Rowzun/Imagine-School-Nepal-Site-NIC-Field-Mapper-Bot/README.md

# Field Mapper Robot

## Overview
Design of a **modular, cost‑effective robot** for mapping magnetic fields within a defined volume.
<div align="center">
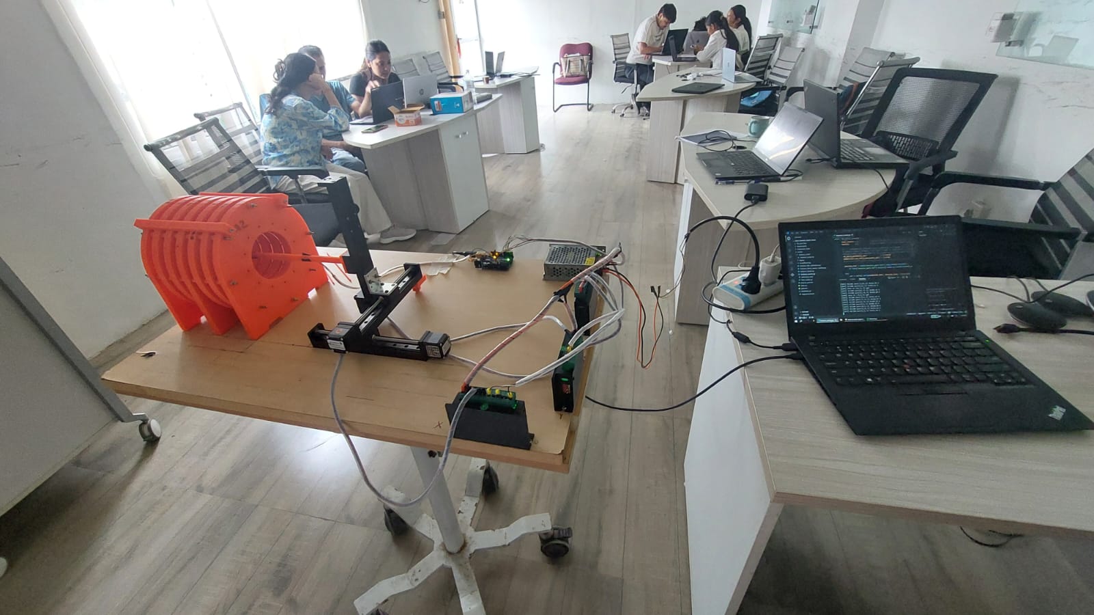
[picture p1: Attachments/image1.jpeg]
  
</div>

## Software requirements
* **PyCharm** – Python IDE (Python 3.13) – [Link](https://www.jetbrains.com/pycharm/)
* **Arduino IDE** – Native Arduino software – [Link](https://www.arduino.cc/en/software/)
* **VS Code** – Native Arduino software – [Link](https://www.arduino.cc/en/software/)

## Hardware requirements
* **CPU:** 64‑bit dual‑core (modern)  
* **RAM:** ≥ 8 GB (PyCharm needs 2 GB free)  
* **Storage:** ≥ 5 GB free SSD (PyCharm ≈ 3.5 GB + projects)  
* **OS:** Windows 10 64‑bit +, macOS 10.15 +, Ubuntu 20.04 +  
* Basic jumper wires for Arduino  
* M3 screws with nuts  
* USB‑C ↔ USB‑C / USB‑A ↔ USB‑C cable (Arduino Uno R4)  
* Wire cutter/stripper  
* Precision screwdriver set  

---

## Bill of Materials
| Component | Qty | Unit Price (USD) | Link |
|---|:---:|:---:|---|
| Linear stages (Z 300 mm, XY 300 mm – 12 mm pitch) | 1 | 338.54 | [Product](https://www.aliexpress.us/item/3256805348651313.html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) |
| M422 stepper driver | 3 | 5.60 | [Product](https://www.aliexpress.us/item/3256805781393725.html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) |
| Arduino UNO | 1 | 16.00 | [Product](https://thepihut.com/products/arduino-uno-r4-minima) |
| SS49e Hall sensor | 1 | 1 | [Product](https://www.alphalabinc.com/products/gm2/?srsltid=AfmBOor0p2l-VF9fIRODsZqY854WaDDNnBIFsOJ6kHjN2p6iCgCOzTLX) |
| **Total** |  | **361.14** |  |

---

## High‑Level Workflow

<div align="center">
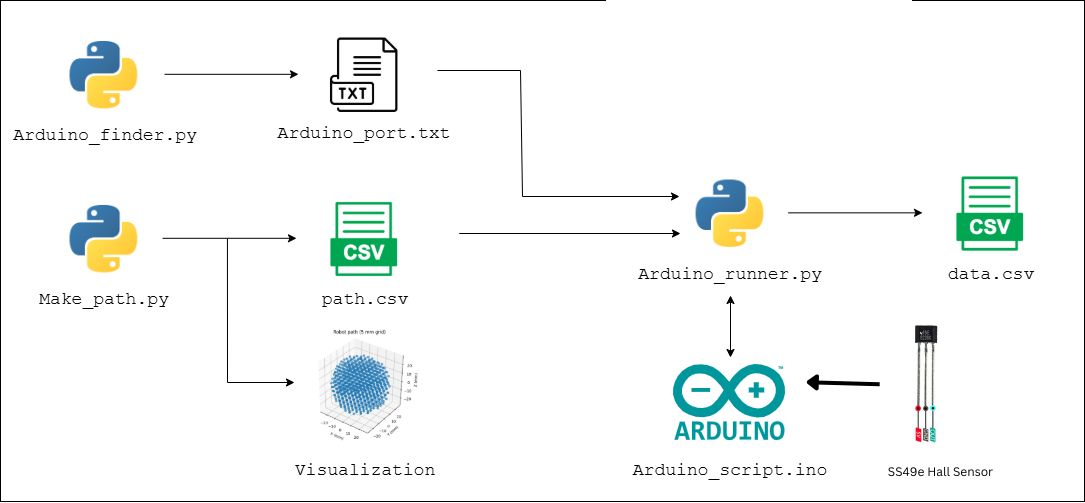
[picture p2: Attachments/draw_1.png]
System flowchart 1
  
</div>
<h3 align="center"><em>Software workflow diagram</em></h3>

<div align="center">
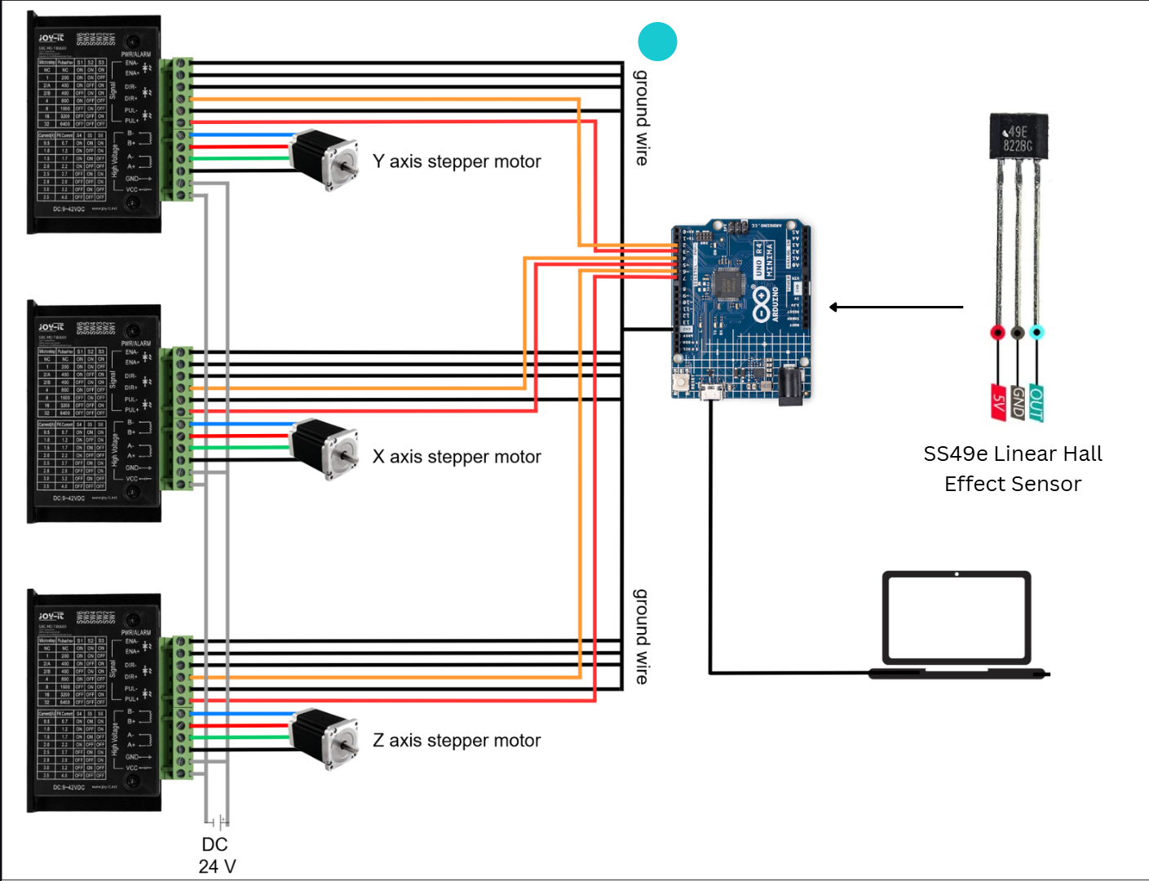
[picture p3: Attachments/draw_2.png]
System flowchart 2
  
</div>
<h3 align="center"><em>Wiring diagram</em></h3>

## Installation and Setup  

1. Clone the repository:  
    ```bash  
    git clone https://github.com/Rowzun/Imagine-School-Nepal-Site-NIC-Field-Mapper-Bot.git
    ```  
2. Install dependencies:  
    ```bash  
    pip install -r requirements.txt  
    ```  
3. Connect the hardware as described in the wiring diagram.
4. Print the files in [3D print files](3D_print_files)
5. Connect and upload [`Arduino_script.ino`](scripts/Arduino_script.ino) to Arduino
6. Run [`Arduino_finder.py`](scripts/Arduino_finder.py)
7. Run [`Path_maker.py`](scripts/Path_maker.py)
8. Run [`Arduino_runner.py`](scripts/Arduino_runner.py)
9. Check out [`Supporting images`](Attachments/Supporting%20images/) for further images
---

## Scripts Overview  

### [`Arduino_finder.py`](scripts/Arduino_finder.py)

- Run once the arduino is connected 
- Finds the connection port name and writes it in Arduino_port.txt file 

### [`Path_maker.py`](scripts/Path_maker.py)

- Generates the path trajectory with discrete points
- Allows user to modify the trajectory and spacing between individual points
- Visualizes the path in 3D with exact sequence the robot would follow, for user to validate
- Writes the x y z coordinates of the path in the right order in "path.CSV" file

### [`Arduino_runner.py`](scripts/Arduino_runner.py)
  
- Allows user to input delay time for sensor read at each desired point and control the speed of robot movement
- Retrieves the coordinates from "path.CSV" file
- Generates text commands to move the robot according to the path
- Sends text commands to arduino at 9600 baud (defined by user) via Arduino port retrieved from Arduino.txt file
- Establishes a serial connection with Gaussmeter through usb port
- Records voltage readings of Gaussmeter per data point and appends to corresponding coordinate
- Generates Data.CSV, containing x y z reading values for each coordinates

### [`Arduino_script.ino`](scripts/Arduino_script.ino)
- Defines Pin map of the arduino
- Listens for simple text commands (X+, X-, Y+, Y-, Z+, Z-,) sent over USB at 9600 baud (Links [`Arduino_runner.py`](scripts/Arduino_runner.py) with Arduino)
- Moves the robot 1 mm per command by pulsing the chosen step pin 533.34 times (defined by callibration)
- Read the raw ADC values from the SS49e hall sensor and using the calibration values, convert the voltage value to gauss and print to serial when prompted

---
## Assembly Tips

### 1 · Axis Ruler for Quick Calibration
<div align="center">
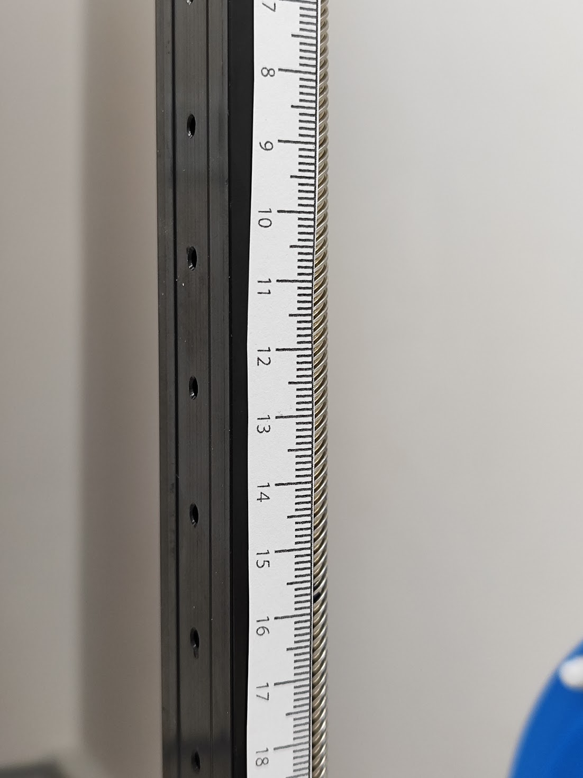
[picture p4: Attachments/tip1.jpg]
  
</div>
Attaching a printed ruler minimises calibration time and ensures precise step‑to‑millimetre mapping.

### 2 · Mount on a Rigid Base
<div align="center">
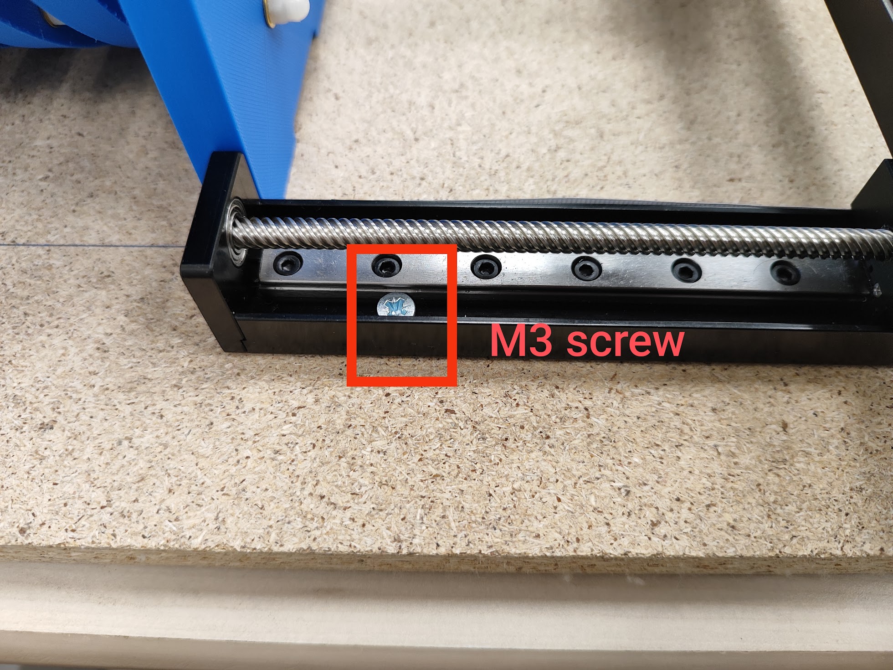
[picture p5: Attachments/tip2.jpg]
Robot mounted on wooden panel
  
</div>
Secure the frame to a **≥ 40 × 60 × 1.5 cm** wooden panel for stability during operation.

### 3 · Variable DC Power Supply
<div align="center">
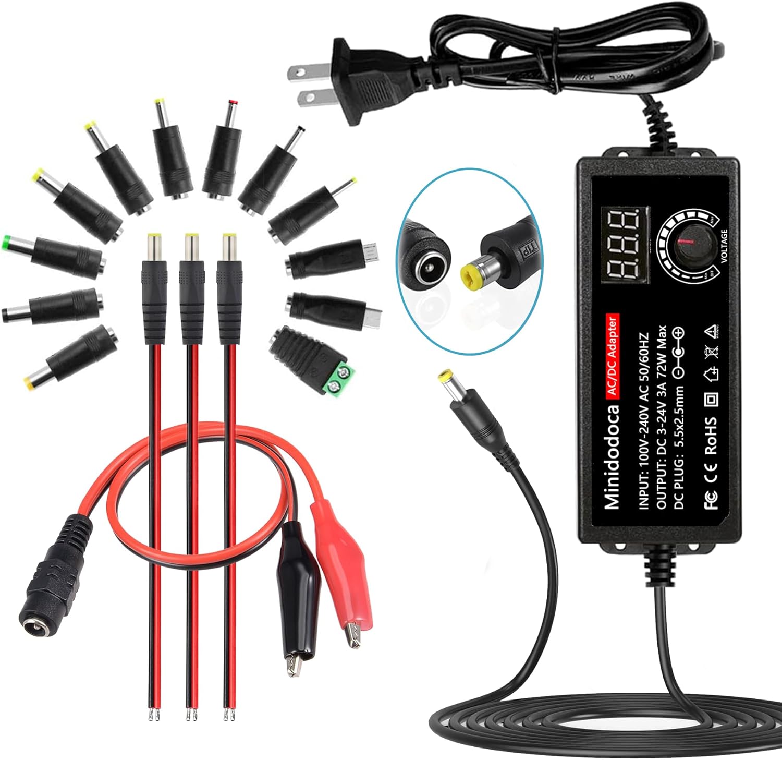
[picture p6: Attachments/tip3.jpg]
Variable DC power supply
  
</div>
A low‑cost variable supply (~15 USD) simplifies testing different motor voltages and current limits.

### 4 · M422 DIP‑Switch Settings
<div align="center">
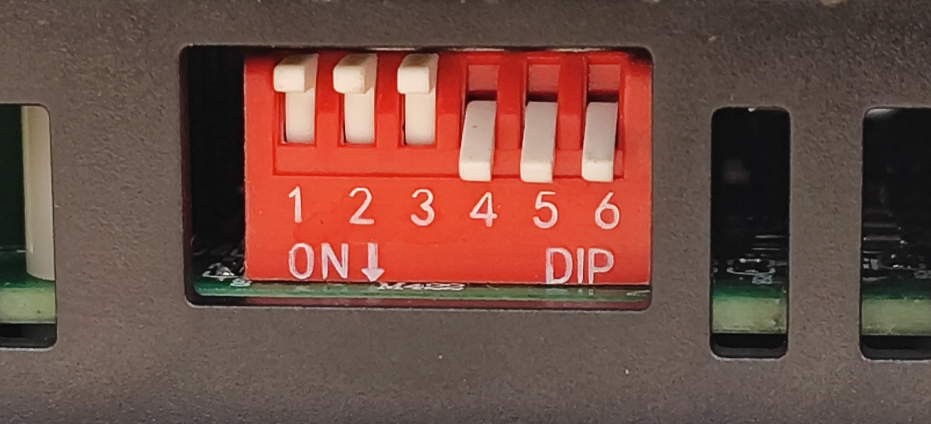
[picture p7: Attachments/tip4.jpg]
TB6600 switch positions
  
</div>
Set switches **S1–S6 = OFF** to match the firmware micro‑stepping and protect the motors.

### 5 . Hall sensor Calibration Steps
- Hall sensor selection: Based on voltage compatibility, linearity, measurement axis, drift etc. We selected SS49e hall sensor due to overall fit and local availability 
- ADC conversion: For the buildlab we selected the internal 10bit SAR based ADC of UNO board with internal 5V reference. In future experiments, we are planning to move to a 16bit external ADC with a clean isolated power supply.
- Measurement of Ground truth Gauss Values: For the N48 12mm cubic magnet used in our build, we obtained values at 1mm spacing in a linear axis using a reference NMR meter.
- Measurement of SS49e sensor output voltage at the same location using same magnet. For this we used our field mapper robot and a script that moves the robot by 1mm and then takes the voltage readings from the sensor after averaging 100 samples.
- Data conditioning and filtering: we removed readings where the 49e hall sensor readings were saturated
- Measurement of V0 (The output value of the sensor in the absence of any magnetic field). Since V0 varies with temperature, fresh V0 values are measured everytime.
- Combine data sets, distance vs Vout (sensor) and distance vs Gauss (NMR meter) to obtain the Gauss Vs Voltage values.
<div align="center">
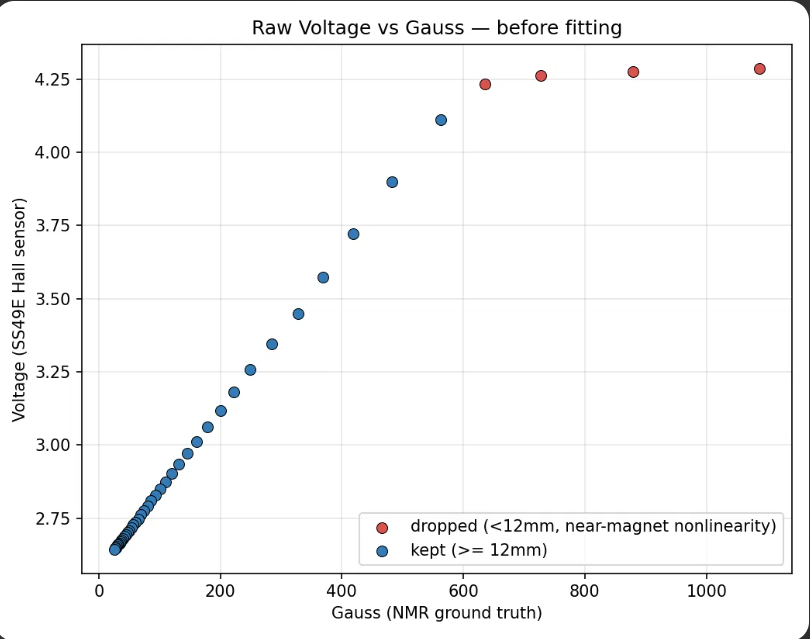
[picture p8: Calibration_Data/Gauss vs voltage.PNG]
Gauss vs voltage curve
  
</div>

- Fit a single parameter linear model
V= Sensitivity*B + V0
<div align="center">
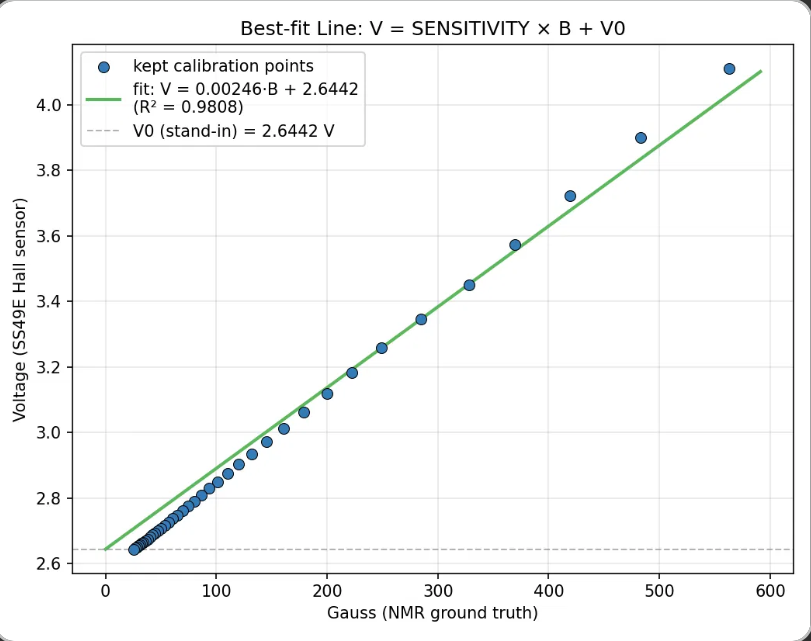
[picture p9: Calibration_Data/Fitting Curve.PNG]
Fitting Curve
  
</div>

- In the arduino script, use the obtained measurement variables, V0 and Sensitivity. 
Bgauss= (Vmeasured-V0)/Sensitivity

---
