Rowzun/Imagine-School-Nepal-Site-NIC-Field-Mapper-Bot/Attachments/Field_mapper_robot.drawio.png

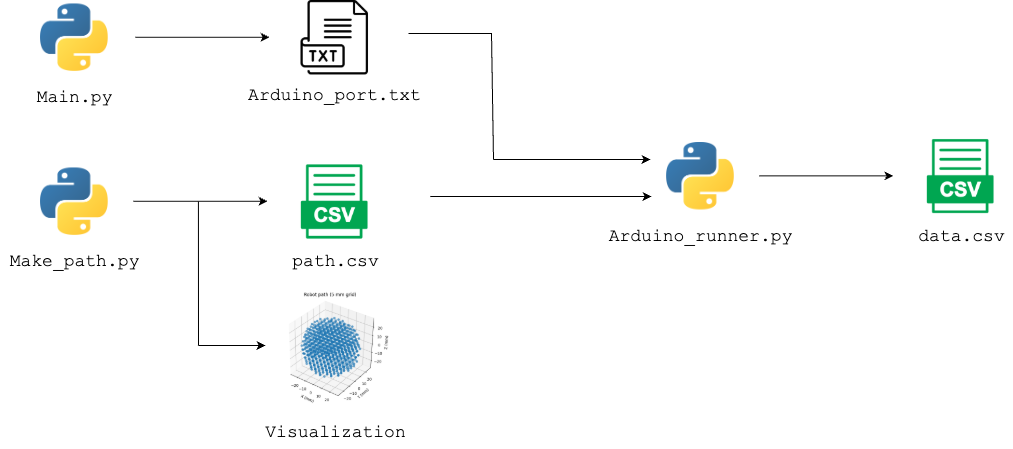
Attachments/Field_mapper_robot.drawio.png
