Rowzun/Imagine-School-Nepal-Site-NIC-Field-Mapper-Bot/Attachments/Images/MAP_118.png

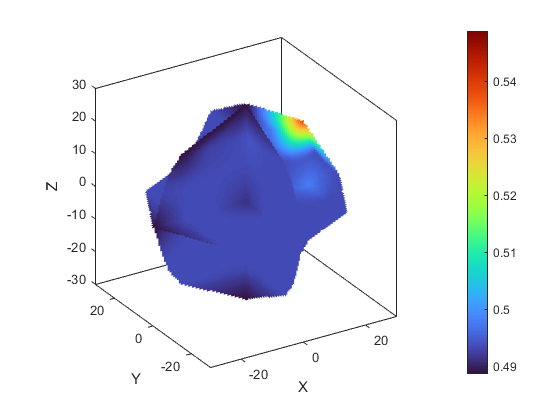
Attachments/Images/MAP_118.png
