Rowzun/Imagine-School-Nepal-Site-NIC-Field-Mapper-Bot/Attachments/Images/Mapper2.png

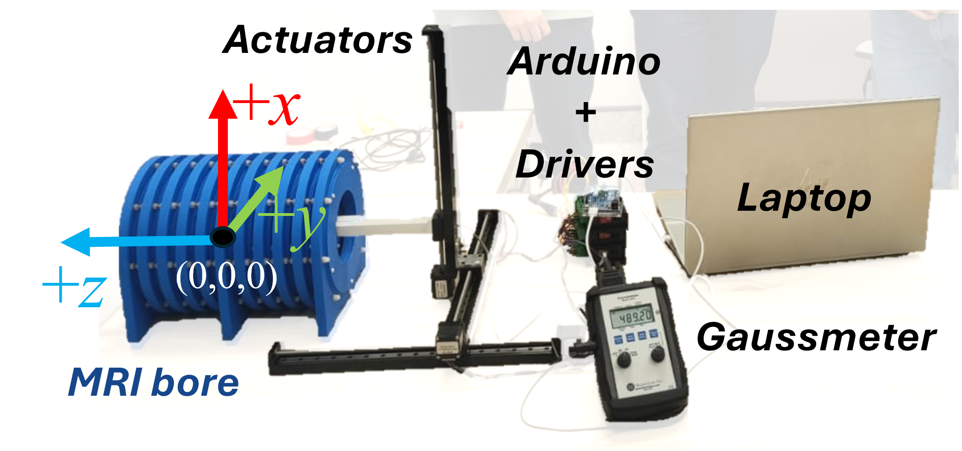
Attachments/Images/Mapper2.png
