Rowzun/Imagine-School-Nepal-Site-NIC-Field-Mapper-Bot/Attachments/Images/scheme3.png

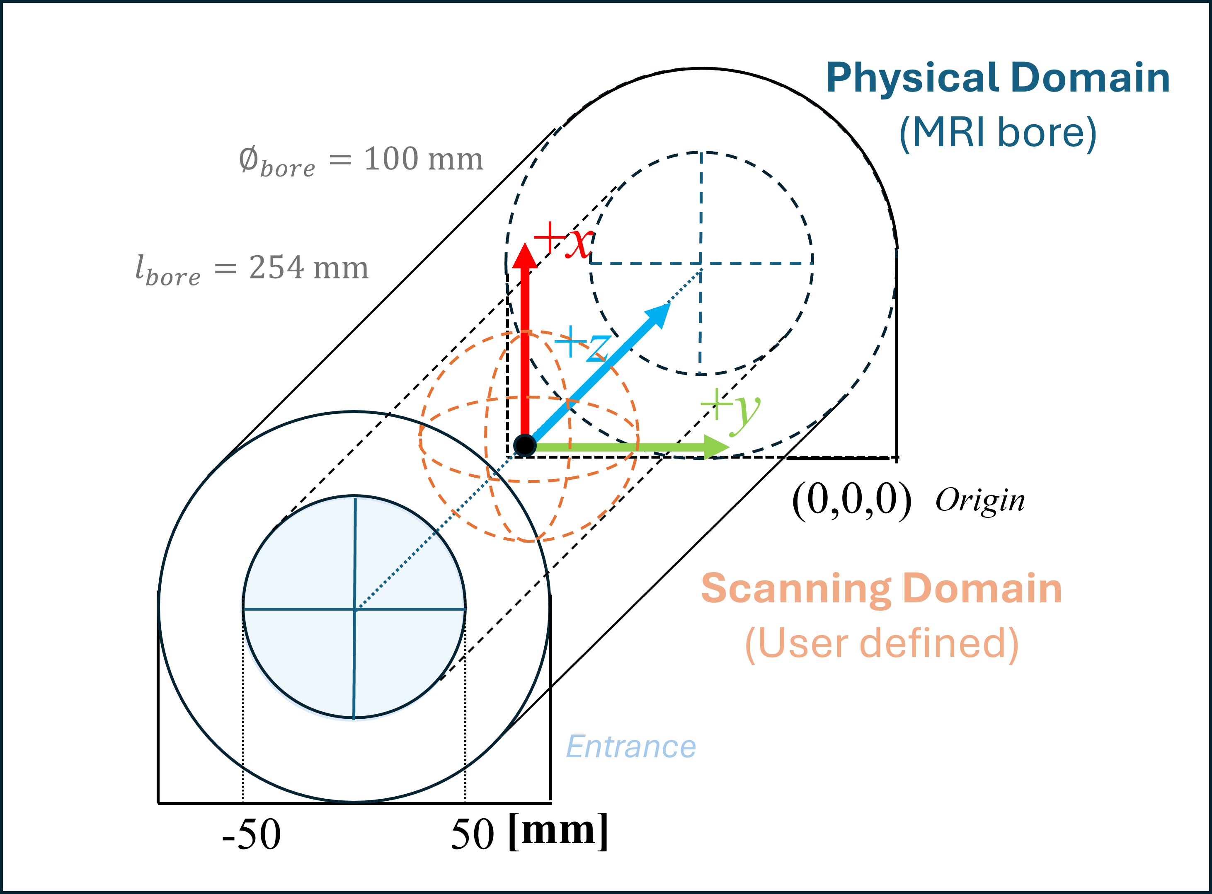
Attachments/Images/scheme3.png
