Rowzun/Imagine-School-Nepal-Site-NIC-Field-Mapper-Bot/Attachments/mount.png

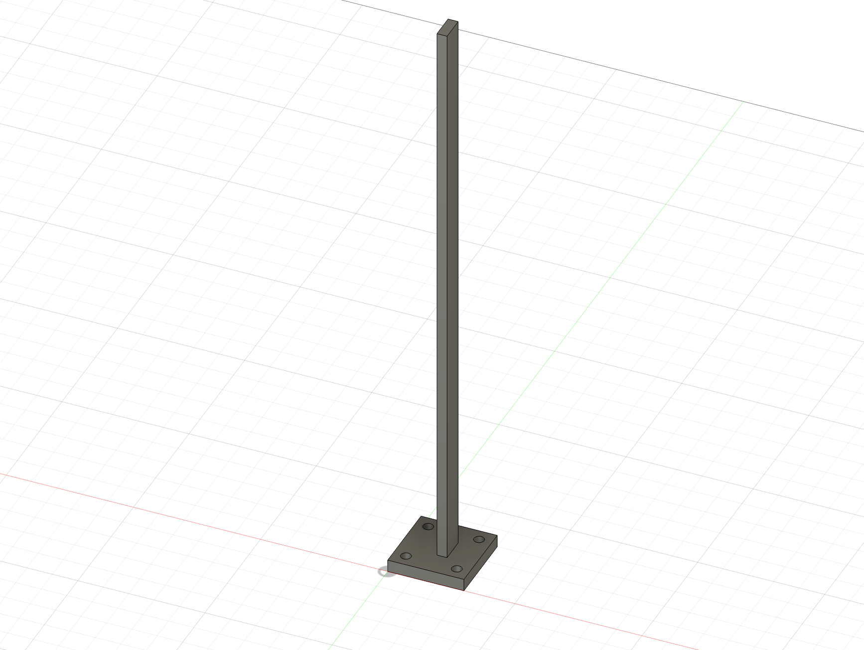
Attachments/mount.png
