Rowzun/Imagine-School-Nepal-Site-NIC-Field-Mapper-Bot/Attachments/Robot.jpg

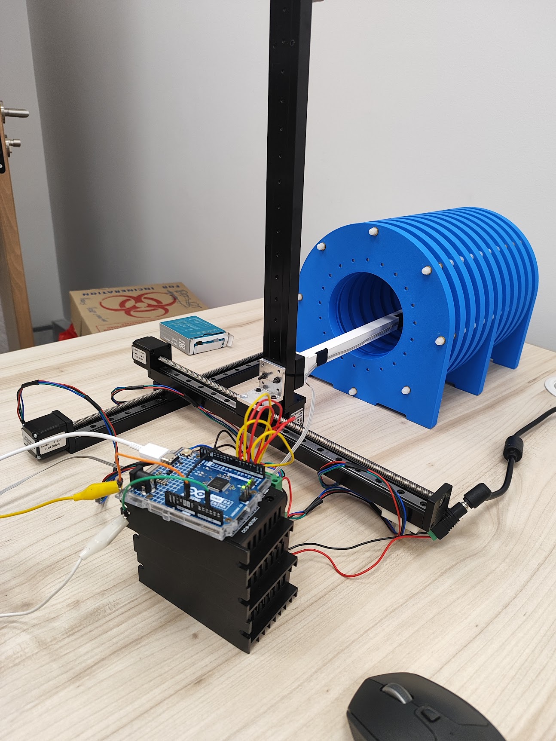
Attachments/Robot.jpg
