Rowzun/Imagine-School-Nepal-Site-NIC-Field-Mapper-Bot/Attachments/Supporting images/2.jpg

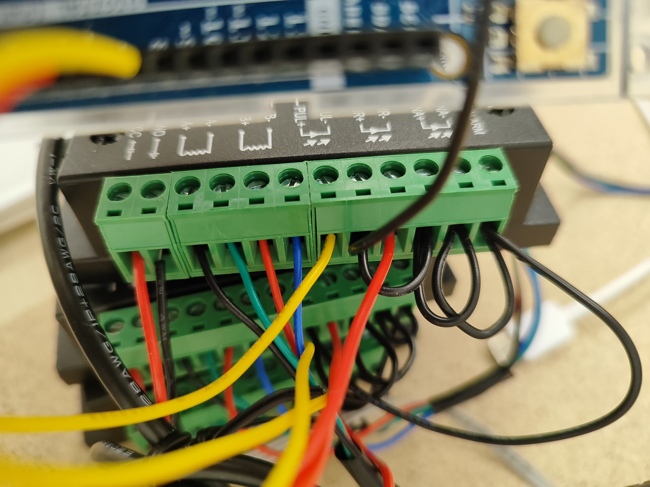
Attachments/Supporting images/2.jpg
