Rowzun/Imagine-School-Nepal-Site-NIC-Field-Mapper-Bot/Attachments/Supporting images/3.jpg

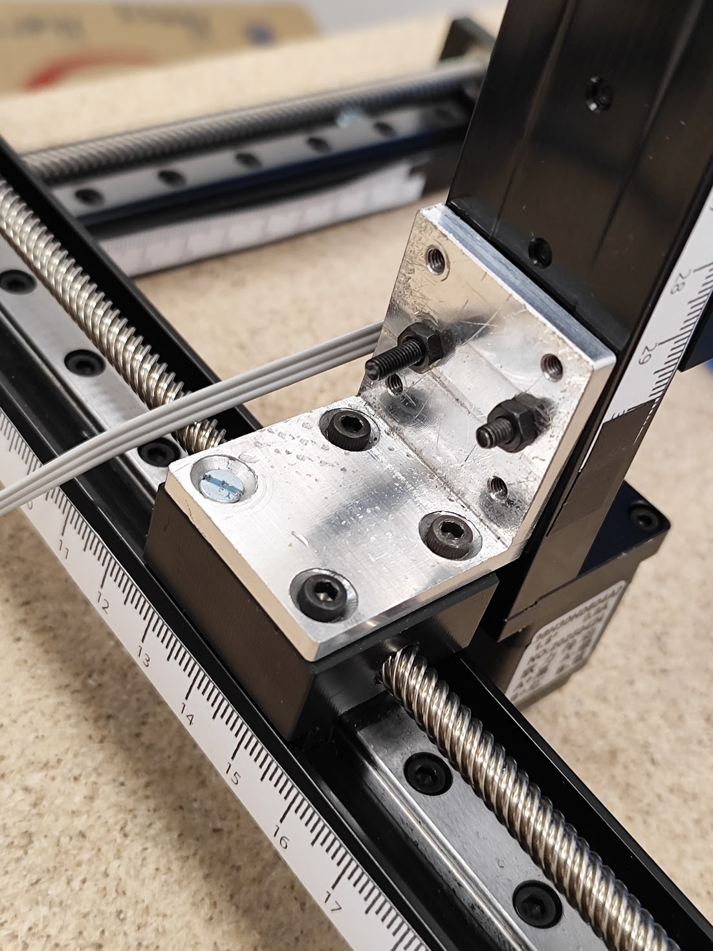
Attachments/Supporting images/3.jpg
