Rowzun/Imagine-School-Nepal-Site-NIC-Field-Mapper-Bot/Attachments/Supporting images/5.jpg

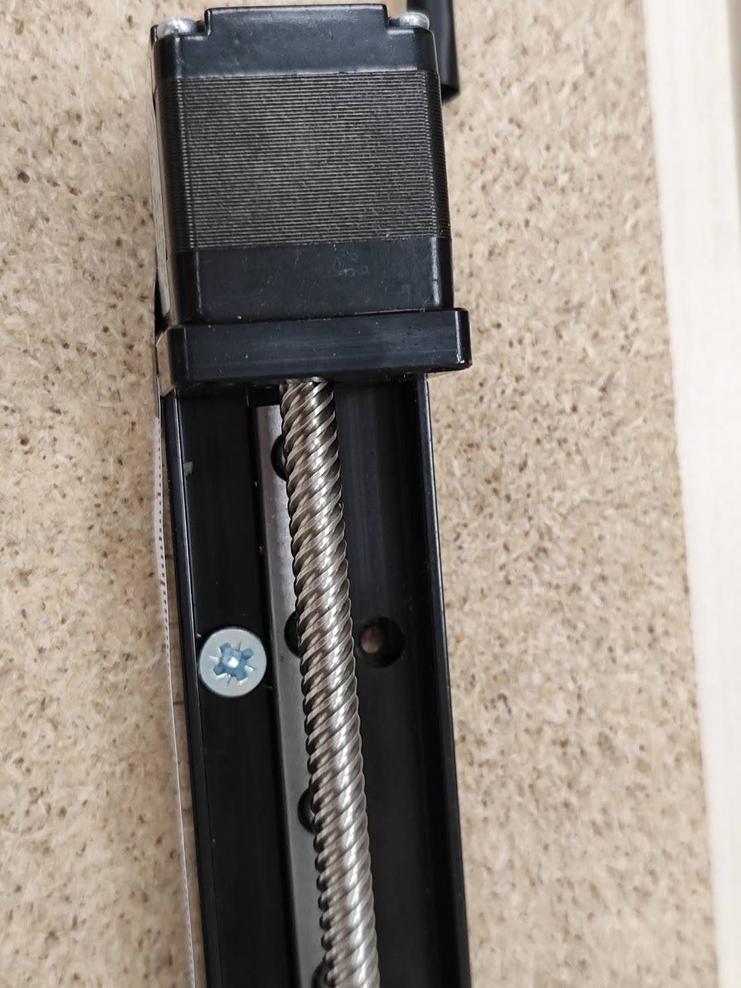
Attachments/Supporting images/5.jpg
