Rowzun/Imagine-School-Nepal-Site-NIC-Field-Mapper-Bot/Attachments/Supporting images/6.jpg

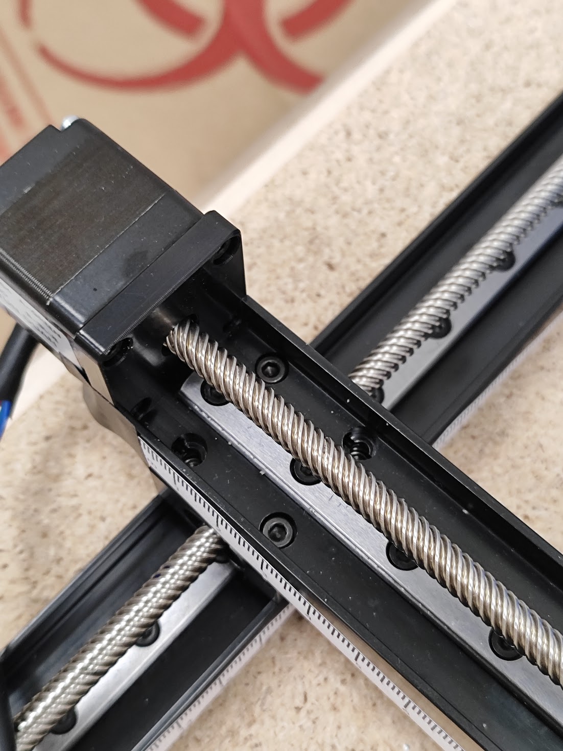
Attachments/Supporting images/6.jpg
