Rowzun/Imagine-School-Nepal-Site-NIC-Field-Mapper-Bot/3D print files/wheel.3mf

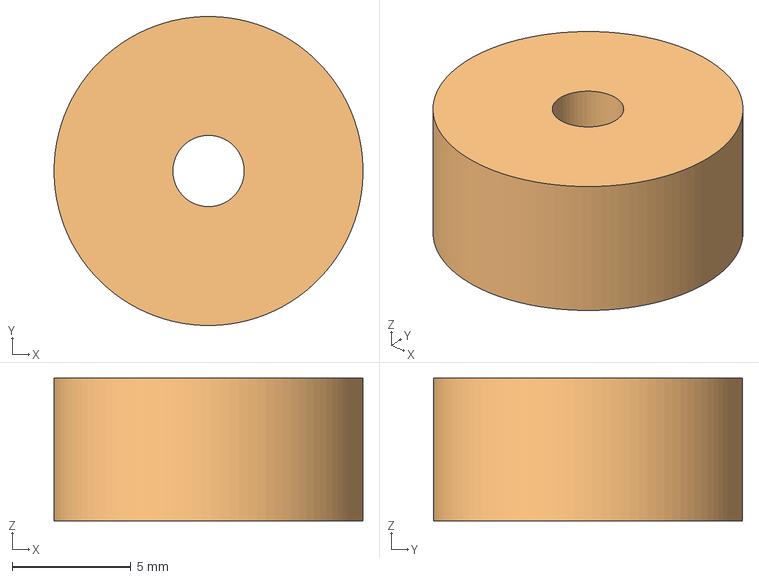
[picture p24: CAD file, 2026-08-13]
3D print files/wheel.3mf
13.0 x 13.0 x 6.00 mm
