Rowzun/Imagine-School-Nepal-Site-NIC-Field-Mapper-Bot/3D print files/Sensor_mount_1.stl

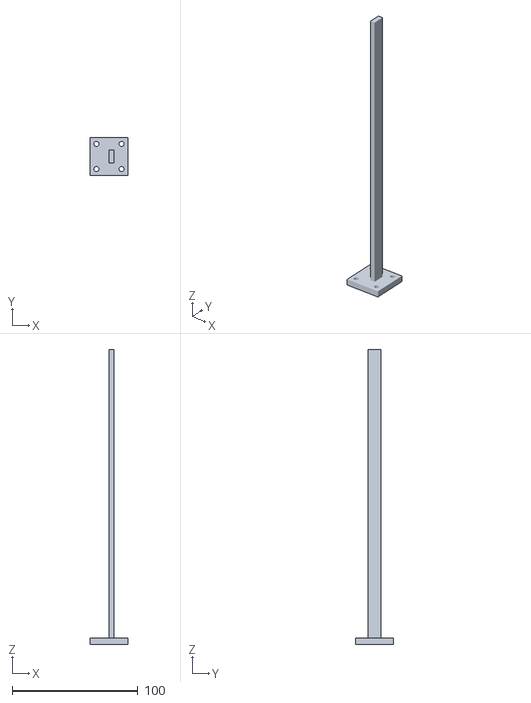
[picture p25: CAD file, 2026-08-13]
3D print files/Sensor_mount_1.stl
30.0 x 30.0 x 235.0
