Rowzun/Imagine-School-Nepal-Site-NIC-Field-Mapper-Bot/3D print files/base.3mf

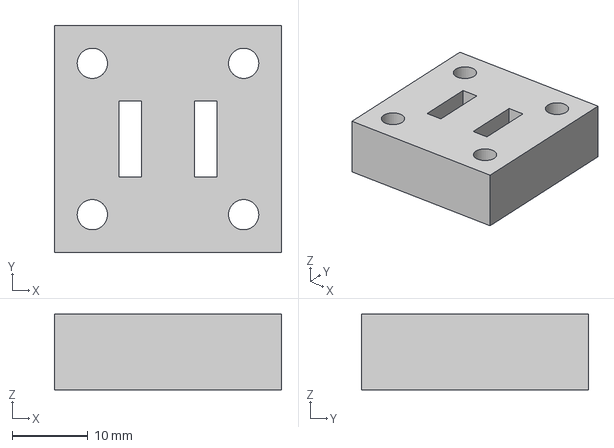
[picture p26: CAD file, 2026-08-13]
3D print files/base.3mf
30.0 x 30.0 x 10.0 mm
