Rowzun/Imagine-School-Nepal-Site-NIC-Field-Mapper-Bot/3D print files/stick.3mf

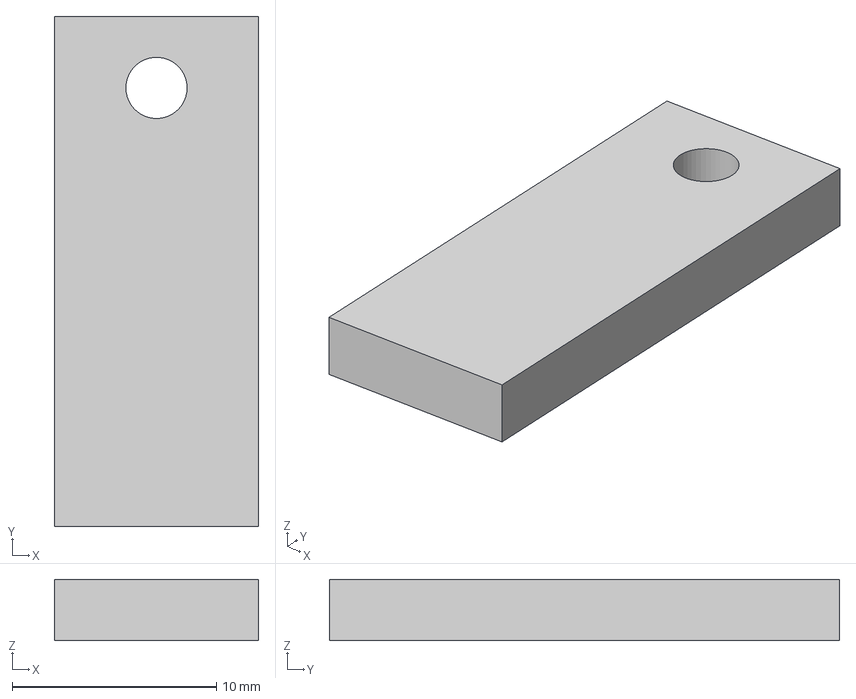
[picture p27: CAD file, 2026-08-13]
3D print files/stick.3mf
10.0 x 25.0 x 3.00 mm
