Rowzun/Imagine-School-Nepal-Site-NIC-Field-Mapper-Bot/(list of files, cad)

Other CAD files:
3D print files/Sensor_mount_1.f3d
