Rowzun/Imagine-School-Nepal-Site-NIC-Field-Mapper-Bot/(commit log)

2026-08-14 Deleted auto calibration
2026-08-14 Deleted unnecessary files from the source repo.
    [Sensor_mount_1.f3d, Sensor_mount_1.stl, base.3mf, stick.3mf, wheel.3mf]
2026-08-14 Revert "Deleted unnecessary files from the source repo."
    This reverts commit 7b642ad74f8ceda407505b8499a4ab08961cfce0.
    [Sensor_mount_1.f3d, Sensor_mount_1.stl, base.3mf, stick.3mf, wheel.3mf]
2026-08-14 Edited readme and Wiring diagram to include hall sensor
